subashsigdel/Rover/Dump/rocker-bogie-rover-chassis.pdf

Rocker-Bogie Rover — Chassis | Side view

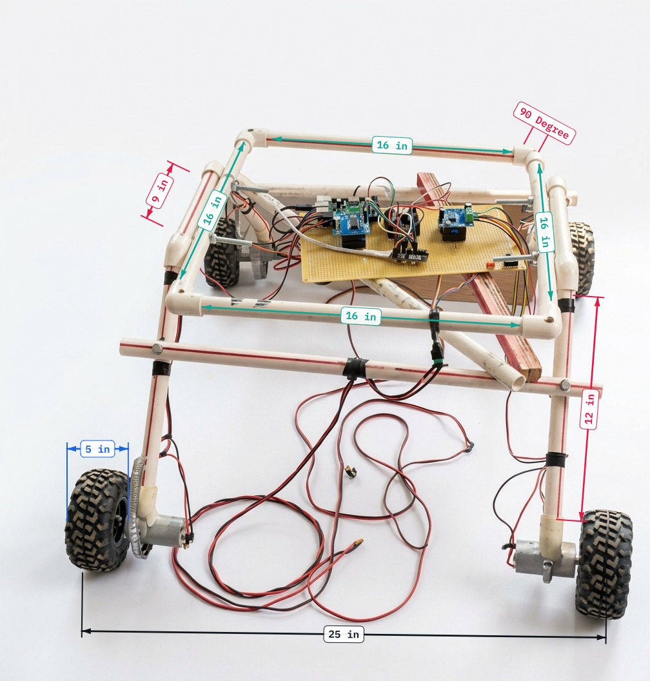
[picture p4: figure]

Uncalibrated — values as annotated | 2026-09-18 | Sheet 1 of 2

Rocker-Bogie Rover — Chassis | Three-quarter view

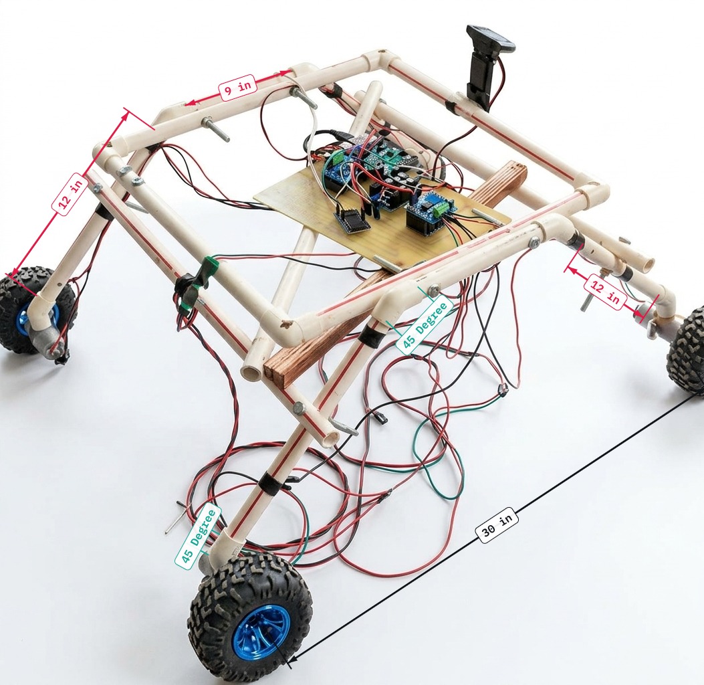
[picture p5: figure]

Uncalibrated — values as annotated | 2026-09-18 | Sheet 2 of 2
