subashsigdel/Rover/Dump/rover_photos.pdf

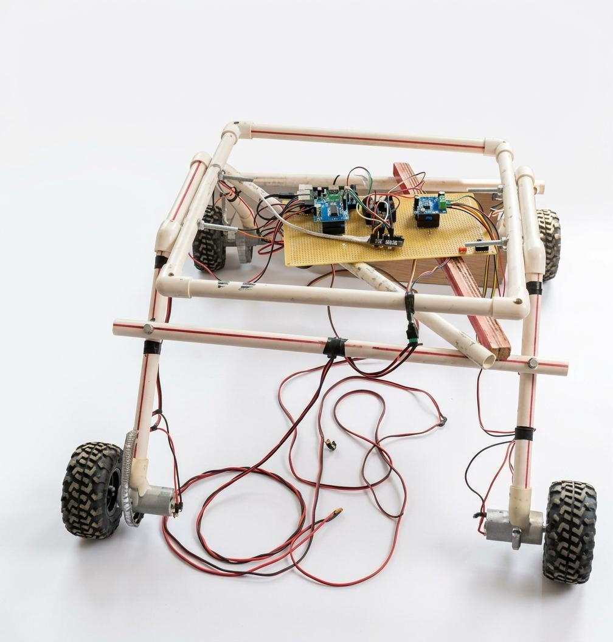
[picture p6: page 1]
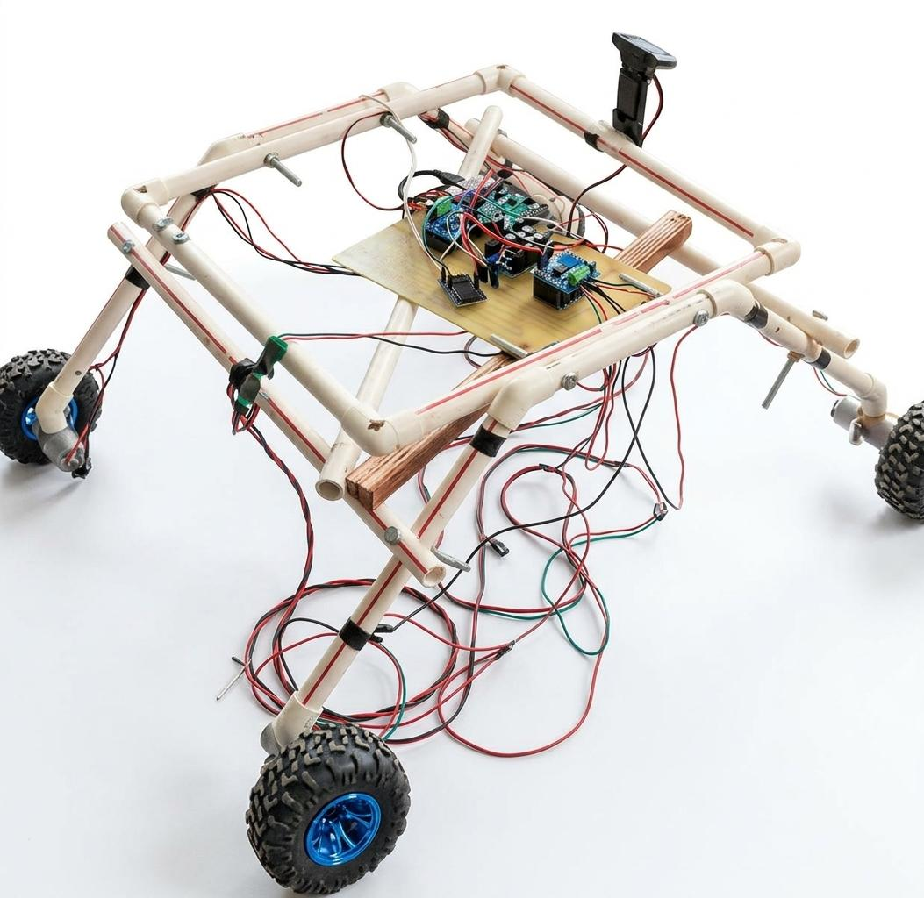
[picture p7: page 2]
